jamead/rfsoc-bxb-fe-eic-hw/3dmodels/MS593-10_Assembly.step

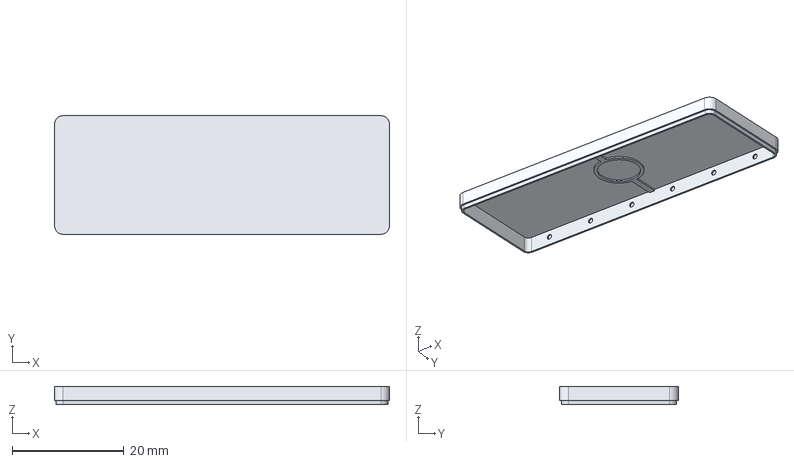
[picture p2: CAD file, 2026-10-16]
3dmodels/MS593-10_Assembly.step
59.9 x 21.2 x 3.30 mm
Frame_MS593-10F
Lid_MS593-10C
