jamead/rfsoc-bxb-fe-eic-hw/3dmodels/RF_Enclosure_4CH_275mil_v5_10hole.step

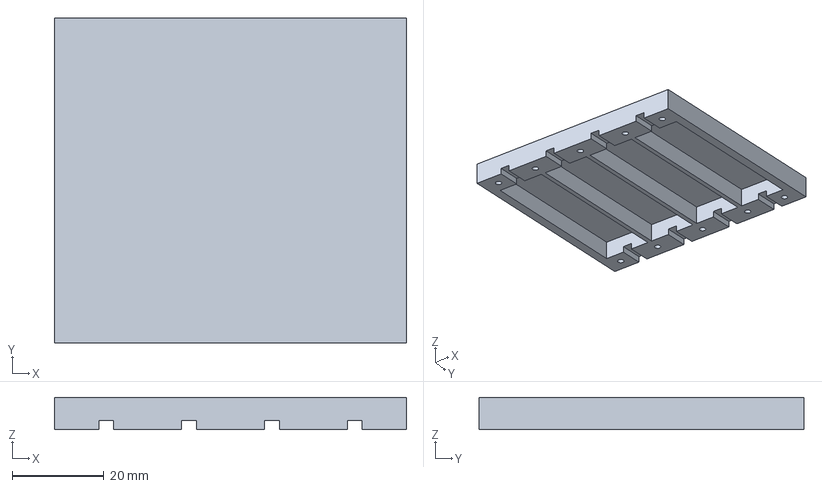
[picture p3: CAD file, 2026-10-28]
3dmodels/RF_Enclosure_4CH_275mil_v5_10hole.step
76.5 x 70.6 x 6.99 mm
