jamead/rfsoc-bxb-fe-eic-hw/3dmodels/MS593-10F.step

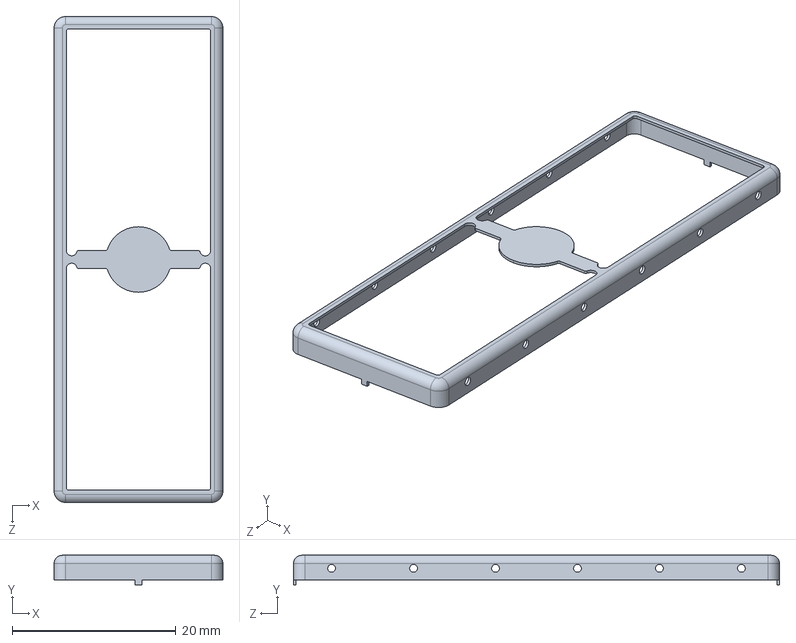
[picture p4: CAD file, 2026-10-23]
3dmodels/MS593-10F.step
20.6 x 3.60 x 59.3 mm
