jamead/rfsoc-bxb-fe-eic-hw/3dmodels/Molex_87831-1420.step

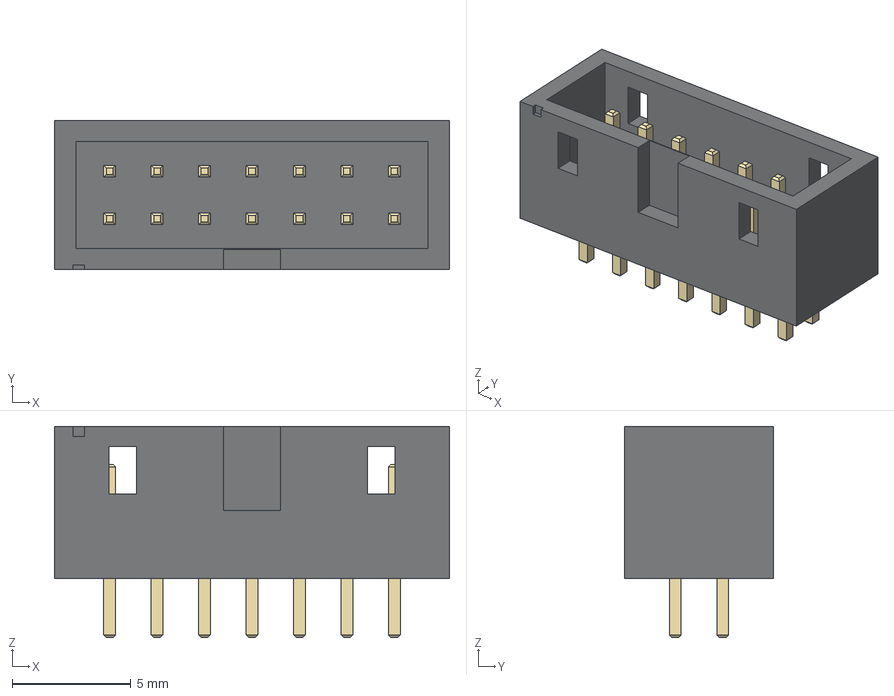
[picture p5: CAD file, 2026-10-16]
3dmodels/Molex_87831-1420.step
16.6 x 6.30 x 8.90 mm
Black_Nylon_Housing
Pin_01
Pin_02
Pin_03
Pin_04
Pin_05
Pin_06
Pin_07
Pin_08
Pin_09
Pin_10
Pin_11
Pin_12
Pin_13
Pin_14
