jamead/rfsoc-bxb-fe-eic-hw/3dmodels/MiniCircuits_XLF-172H+.step

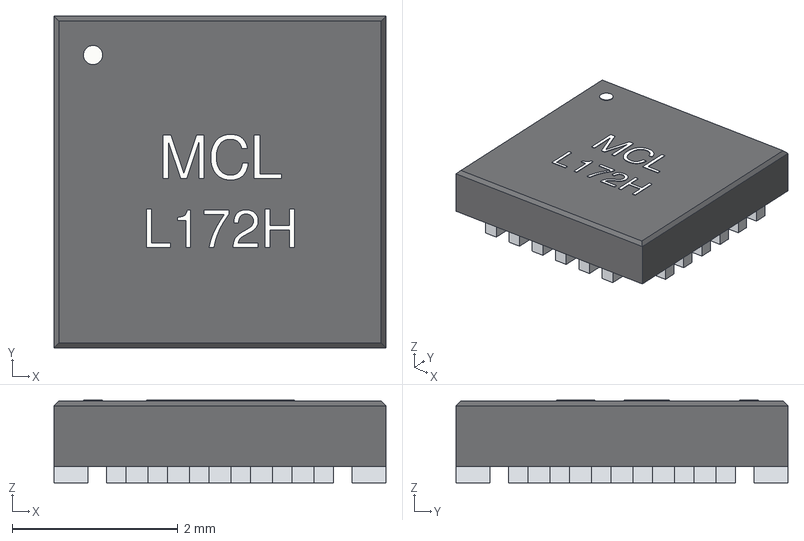
[picture p6: CAD file, 2026-10-16]
3dmodels/MiniCircuits_XLF-172H+.step
4.00 x 4.00 x 1.00 mm
black_plastic_body_4x4x1mm
paddle_GND
pin1_index_dot
top_MCL
top_L172H
