jamead/rfsoc-bxb-fe-eic-hw/3dmodels/MS593-10F_Frame.step

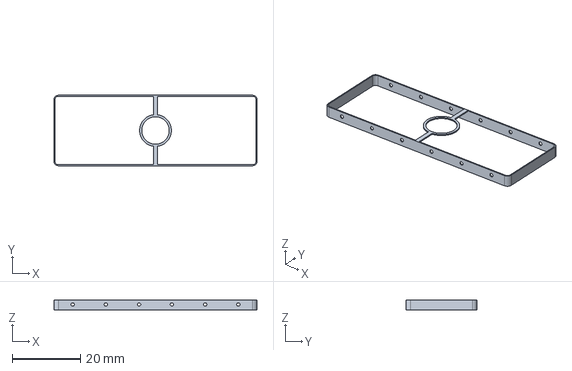
[picture p7: CAD file, 2026-10-16]
3dmodels/MS593-10F_Frame.step
59.3 x 20.6 x 3.00 mm
