jamead/rfsoc-bxb-fe-eic-hw/3dmodels/MS593-10C_Cover.step

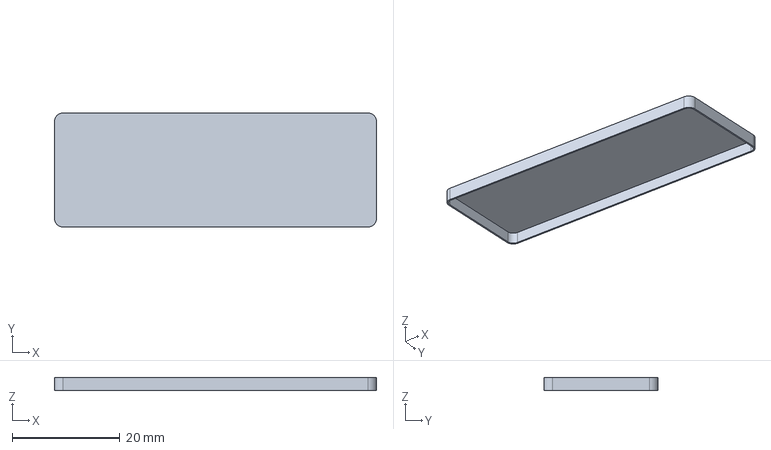
[picture p8: CAD file, 2026-10-16]
3dmodels/MS593-10C_Cover.step
59.9 x 21.2 x 2.50 mm
