jamead/rfsoc-bxb-fe-eic-hw/3dmodels/pSemi_PE43712B-Z.step

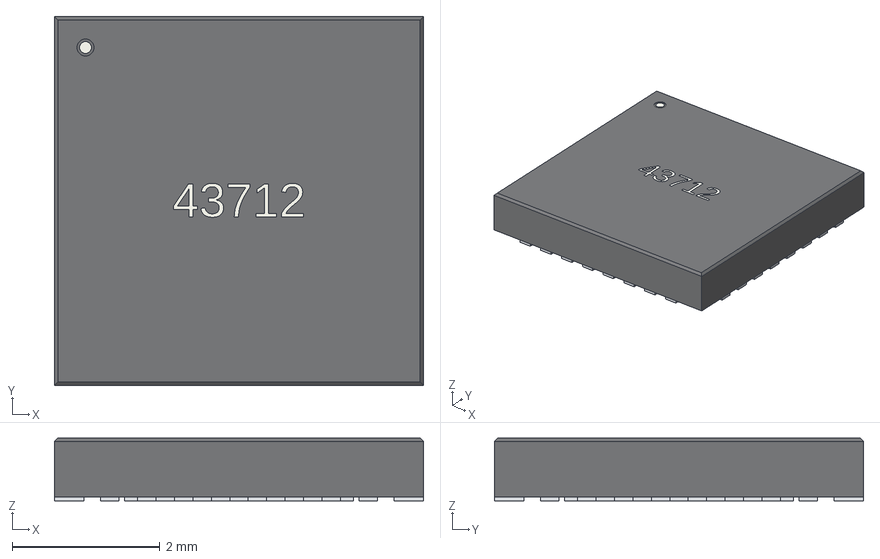
[picture p9: CAD file, 2026-10-16]
3dmodels/pSemi_PE43712B-Z.step
5.00 x 5.00 x 0.85 mm
molded_plastic_body
pin1_index_dot
lead_01
lead_02
lead_03
lead_04
lead_05
lead_06
lead_07
lead_08
lead_09
lead_10
lead_11
lead_12
lead_13
lead_14
lead_15
lead_16
lead_17
lead_18
lead_19
lead_20
lead_21
lead_22
lead_23
lead_24
lead_25
lead_26
lead_27
lead_28
lead_29
lead_30
lead_31
lead_32
EP_center_ground_paddle
43712_top_mark
