jamead/rfsoc-bxb-fe-eic-hw/3dmodels/MiniCircuits_RCAT-01+.step

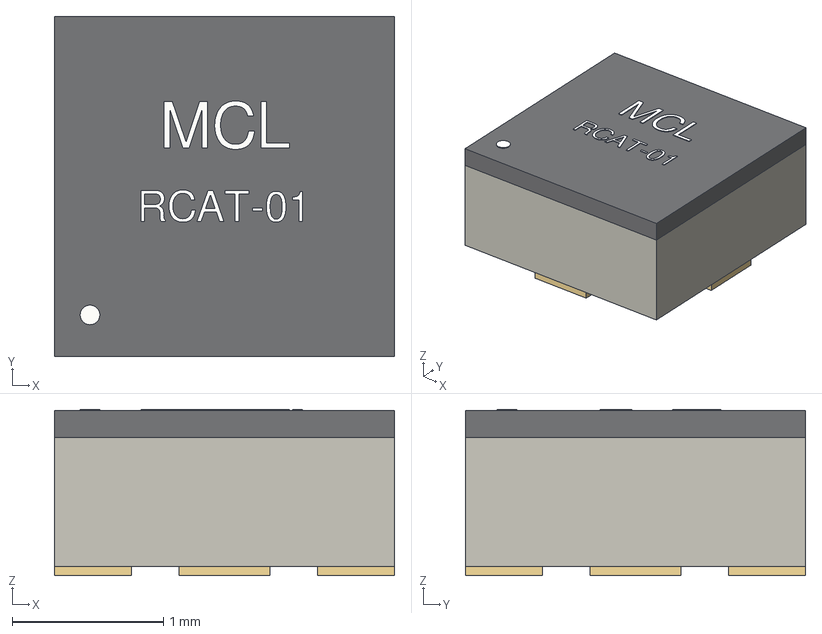
[picture p10: CAD file, 2026-10-16]
3dmodels/MiniCircuits_RCAT-01+.step
2.25 x 2.25 x 1.10 mm
ceramic_substrate
black_ceramic_top
pad1_RF
pad2_GND
pad3_RF
pad4_GND
pin1_index
top_MCL
top_RCAT_01
