jamead/rfsoc-bxb-fe-eic-hw/3dmodels/0402DC.STEP

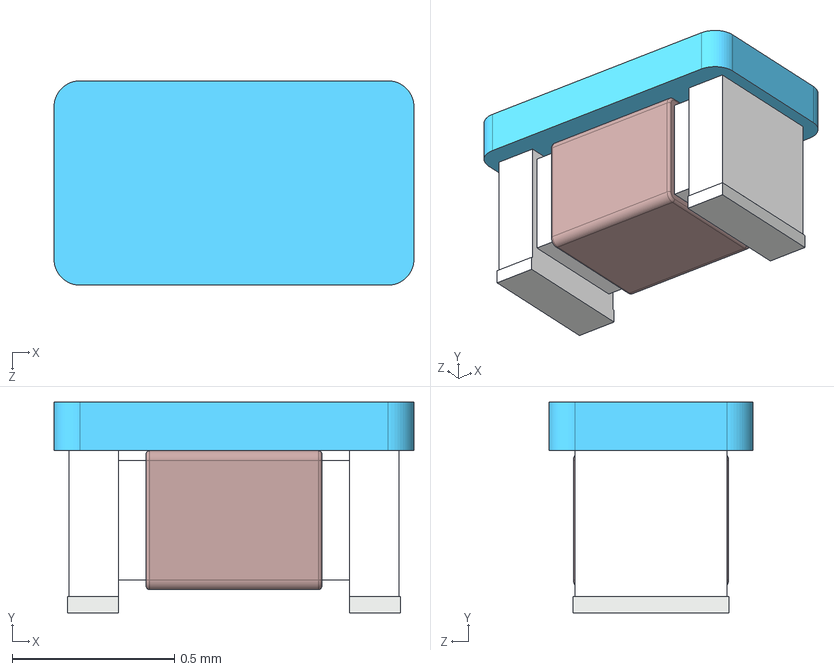
[picture p11: CAD file, 2026-10-16]
3dmodels/0402DC.STEP
1.11 x 0.65 x 0.63 mm
