jamead/rfsoc-bxb-fe-eic-hw/(commit log)

2026-10-16 Move mounting holes
2026-10-23 Add part numbers for BOM
